tannewt/classic-2-trackball/hardware/electronics/PCBs/kicad/vertical_left/left-base.3mf

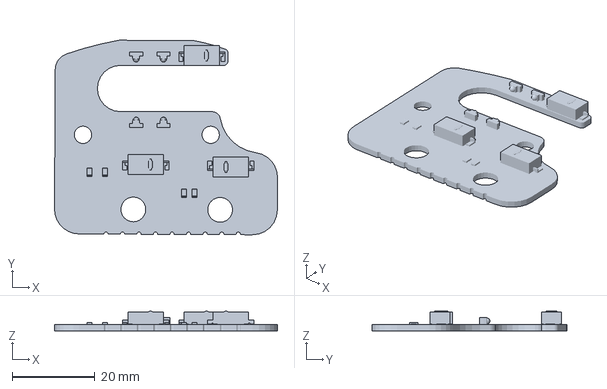
[picture p2: CAD file, 2026-08-16]
hardware/electronics/PCBs/kicad/vertical_left/left-base.3mf
53.9 x 47.1 x 4.80 mm
