tannewt/classic-2-trackball/hardware/electronics/PCBs/kicad/base2/left-base.step

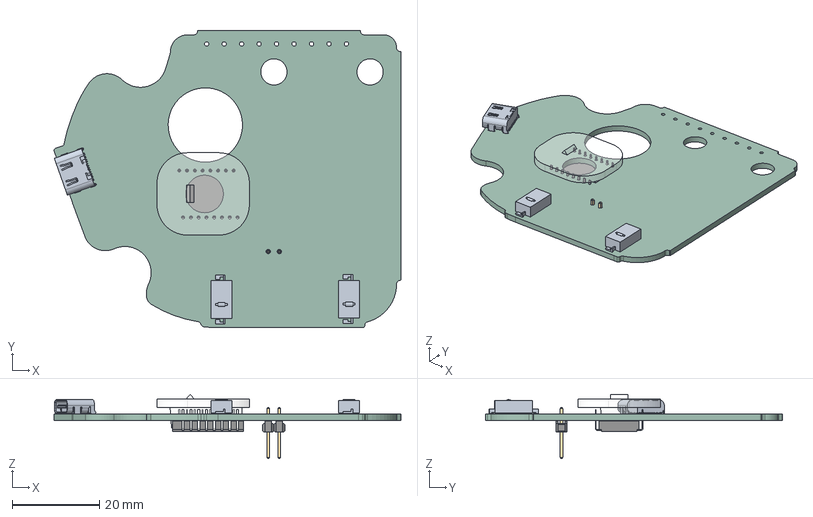
[picture p3: CAD file, 2026-03-19]
hardware/electronics/PCBs/kicad/base2/left-base.step
79.4 x 68.0 x 14.7 mm
K3D-DX07S016JA1-V1_JAE_Proprietary
D2LS_21_BUTTON x 2
D2LS_21_BASE x 2
M20-999-MOULD
M20-999-PIN x 2
LM19-LSI
PMW3360DM-T2QU
Base_PCB
