tannewt/classic-2-trackball/(list of files, cad)

Other CAD files:
hardware/electronics/PCBs/kicad/vertical_left/left-base.stl
