tannewt/classic-2-trackball/hardware/electronics/PCBs/kicad/base2/Base.kicad_pcb

## KiCad design hardware/electronics/PCBs/kicad/base2/Base.kicad_pcb (2026-08-25)

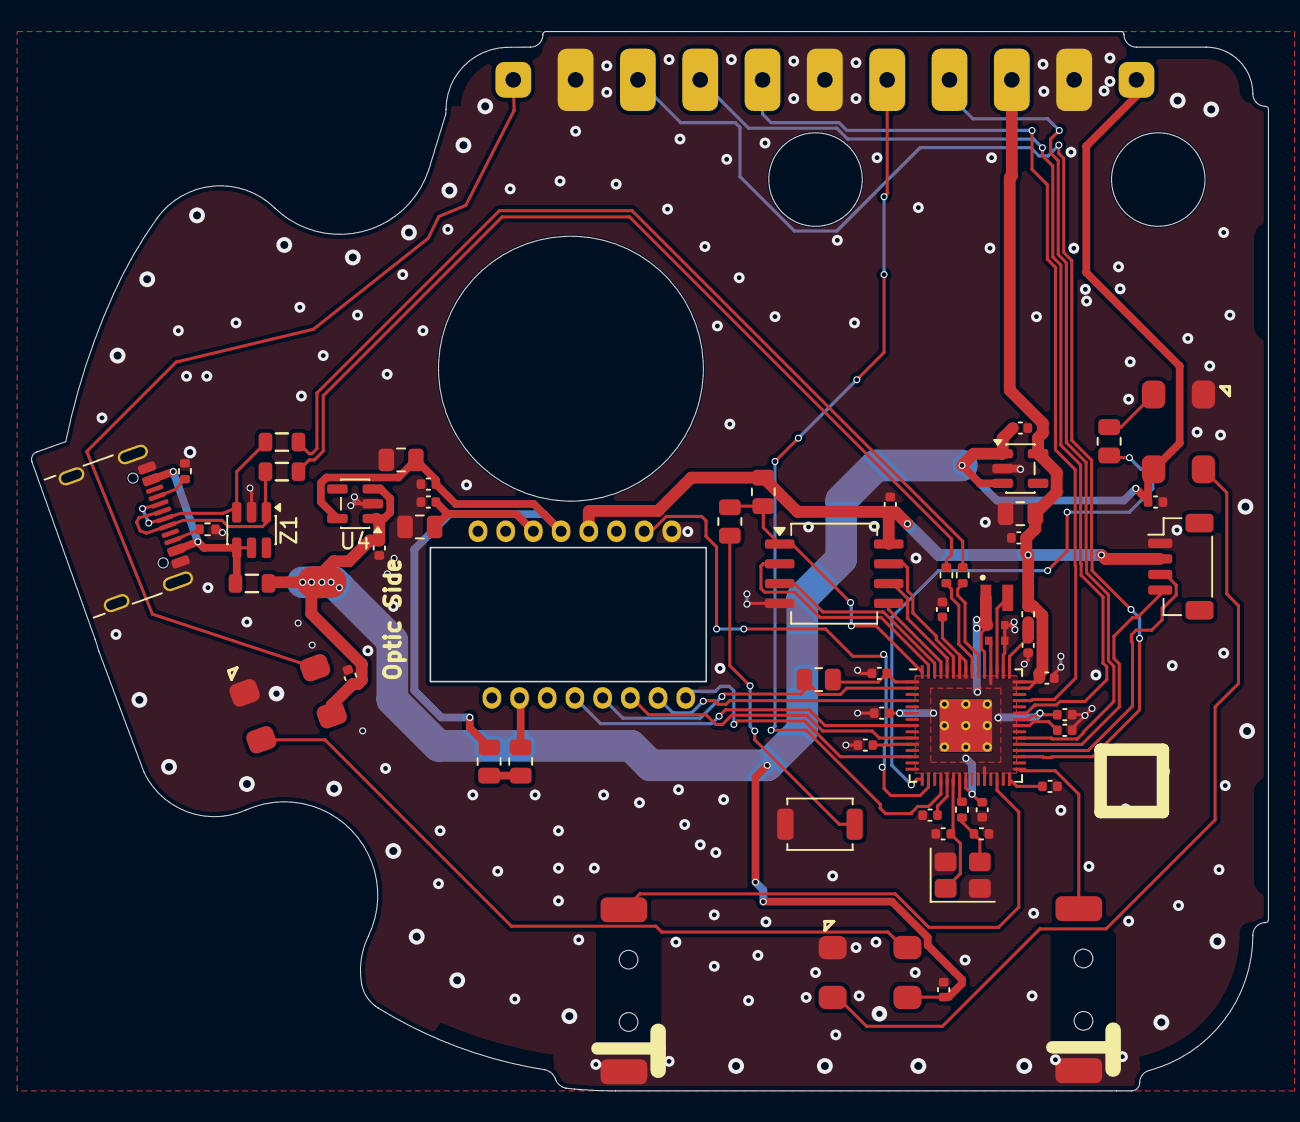
[picture p4: board hardware/electronics/PCBs/kicad/base2/Base.kicad_pcb from above]

Board: 2 copper layers, 79.4 x 68.0 mm, 69 parts (1 on the bottom side), 49 nets.

Parts:
C1, C11, C15, C20, C23, C24, C25, C29, C30, C31, C32, C33, C34, C35: 100nF; C_0402_1005Metric
C3, C4: 15pF; C_0402_1005Metric
C10, C13, C17: 10uF; C_0805_2012Metric
C12, C14, C16, C18: 1uF; C_0402_1005Metric
C22, C28: 4.7uF; C_0402_1005Metric
C26, C27: 4.7uF; C_0402_1005Metric_small_pads
CJ1, CJ2, CJ3, CJ4, CJ5, CJ6, CJ7, CJ8, CJ9, CJ10, CJ11: PCBJointCastellationJoint; PCBJoint
D1, D3, D5: IN-PI55TATPRPGPB
FB1, FB2, FB3: GZ2012D601TF; FB_0805
J3: USB_C_Receptacle_USB2.0_16P; USB_C_Receptacle_HRO_TYPE-C-31-M-31
J14: Conn_01x04; JST_SH_BM04B-SRSS-TB_1x04-1MP_P1.00mm_Vertical
L1: AOTA-B201610S3R3-101-T; L_pol_2016
R1, R16: 1k; R_0805_2012Metric
R2, R5: 10k; R_0805_2012Metric
R3, R4: 22R; R_0805_2012Metric
R6: 33; R_0402_1005Metric
R7, R8: 27; R_0402_1005Metric
R9: 1k; R_0402_1005Metric
R10, R11: 5.1k; R_0402_1005Metric
SW1, SW2: D2LS-21
SW3: TS-1088-AR02016; SW_SPST_TS-1088-xR020
U1: W25Q16JVSSIQ; SOIC-8_5.3x6.2mm_P1.27mm
U2: PMW3360DM-T2QU
U3: AP2202K-3.3; SOT-23-5
U4: AP2204K-1.8; SOT-23-5
U6: RP2350A; RP2350-QFN-60-1EP_7x7_P0.4mm_EP3.4x3.4mm_ThermalVias
Y1: ABM8-272-T3; Crystal_SMD_3225-4Pin_3.2x2.5mm
Z1: IP4220CZ6,125; SOT-23-6

Connections:
+1V1: C15.1, C22.1, C24.1, C27.1, L1.1, U6.6 (DVDD), U6.23 (DVDD), U6.39 (DVDD), U6.50 (VREG_FB)
+3.3V: C1.2, C13.2, C14.2, C26.1, C29.1, C30.1, C31.1, C32.1, C33.1, C34.1, C35.1, CJ8.1 (1_1), J14.2, R2.1, R5.2, R6.1, U1.8 (VCC), U2.5 (VDDIO), U3.5 (VOUT), U6.1 (IOVDD), U6.11 (IOVDD), U6.20 (IOVDD), U6.26 (RUN), U6.30 (IOVDD), U6.38 (IOVDD), U6.44 (ADC_AVDD), U6.45 (IOVDD), U6.49 (VREG_VIN), U6.53 (USB_OTP_VDD), U6.54 (QSPI_IOVDD)
/LBS/ButtonLittleFinger: SW2.B, U6.31 (GPIO19)
/LBS/ButtonRingFinger: SW1.B, U6.28 (GPIO17)
/LED/LEDData: R16.2, U6.16 (GPIO12)
/LED/LEDDataOut: CJ10.1 (1_1), D5.2 (DOUT)
/LED/V_USB: C12.2, C16.2, C20.2, C23.2, C25.2, CJ11.1 (1_1), D1.1 (VDD), D3.1 (VDD), D5.1 (VDD), FB1.2, U3.1 (VIN), U3.3 (EN), U4.1 (VIN), U4.3 (EN)
/MCU/ButtonLeftClick: CJ6.1 (1_1), U6.19 (GPIO15)
/MCU/ButtonRightClick: CJ7.1 (1_1), U6.36 (GPIO24)
/MCU/ButtonScrollWheel: CJ2.1 (1_1), U6.33 (GPIO21)
/MCU/CS: R1.2, R2.2, U1.1 (~CS), U6.60 (~QSPI_SS)
/MCU/D+: R8.2, U6.52 (USB_DP)
/MCU/D-: R7.2, U6.51 (USB_DM)
/MCU/MISO: R5.1, U2.12 (MISO), U6.2 (GPIO0)
/MCU/MOSI: U2.11 (MOSI), U6.10 (GPIO7)
/MCU/MOTION: U2.9 (MOTION), U6.13 (GPIO9)
/MCU/SCLK: U2.10 (SCLK), U6.4 (GPIO2)
/MCU/ScrollWheelOpto0: CJ3.1 (1_1), U6.40 (GPIO26/ADC0)
/MCU/ScrollWheelOpto1: CJ4.1 (1_1), U6.42 (GPIO28/ADC2)
/MCU/VREG_AVDD: C28.1, R6.2, U6.46 (VREG_AVDD)
/MCU/VREG_LX: L1.2, U6.48 (VREG_LX)
/MCU/XIN: C3.1, U6.21 (XIN), Y1.1
/MCU/XOUT: R9.1, U6.22 (XOUT)
/MCU/~CS: U2.13 (~CS), U6.8 (GPIO5)
/MCU/~RESET: U2.7 (~RESET), U6.17 (GPIO13)
/MOS/1V8: C17.2, C18.2, R3.2, U2.4 (VDD), U4.5 (VOUT)
/SCL: J14.4, U6.35 (GPIO23)
/SDA: J14.3, U6.34 (GPIO22)
/USB/USB_D+: FB3.2, R8.1
/USB/USB_D-: FB2.2, R7.1
GND: C1.1, C3.2, C4.2, C10.1, C11.1, C12.1, C13.1, C14.1, C15.2, C16.1, C17.1, C18.1, C20.1, C22.2, C23.1, C24.2, C25.1, C26.2, C27.2, C28.2, C29.2, C30.2, C31.2, C32.2, C33.2, C34.2, C35.2, CJ1.1 (1_1), CJ5.1 (1_1), CJ9.1 (1_1), D1.3 (VSS), D3.3 (VSS), D5.3 (VSS), J3.A1 (GND), J3.A12 (GND), J3.B1 (GND), J3.B12 (GND), J3.SH (SHIELD), J14.1, R10.2, R11.2, SW1.A, SW2.A, SW3.1, U1.4 (GND), U2.8 (GND), U3.2 (GND), U4.2 (GND), U6.47 (VREG_PGND), U6.61 (GND), Y1.2, Y1.4, Z1.2
unnamed: C4.1, R9.2, Y1.3
unnamed: D1.4 (DIN), R16.1
unnamed: D1.2 (DOUT), D3.4 (DIN)
unnamed: D3.2 (DOUT), D5.4 (DIN)
unnamed: FB1.1, J3.A4 (VBUS), J3.A9 (VBUS), J3.B4 (VBUS), J3.B9 (VBUS), Z1.4, Z1.5
unnamed: FB2.1, J3.A7 (D-), J3.B7 (D-), Z1.3
unnamed: FB3.1, J3.A6 (D+), J3.B6 (D+), Z1.1
unnamed: J3.A5 (CC1), R10.1
unnamed: J3.B5 (CC2), R11.1
unnamed: R1.1, SW3.2
unnamed: R3.1, R4.2
unnamed: U1.6 (CLK), U6.56 (QSPI_SCLK)
unnamed: U1.5 (DI_(IO0)), U6.57 (QSPI_SD0)
unnamed: U1.2 (DO_(IO1)), U6.59 (QSPI_SD1)
unnamed: U1.7 (~HOLD_or_~RESET_(IO3)), U6.55 (QSPI_SD3)
unnamed: U1.3 (~WP_(IO2)), U6.58 (QSPI_SD2)
unnamed: R4.1, U2.15 (LED_P)
unnamed: C10.2, C11.2, U2.3 (VDDPIX)
