tannewt/classic-2-trackball/hardware/electronics/PCBs/kicad/vertical_left/Vertical.kicad_pcb

## KiCad design hardware/electronics/PCBs/kicad/vertical_left/Vertical.kicad_pcb (2026-08-16)

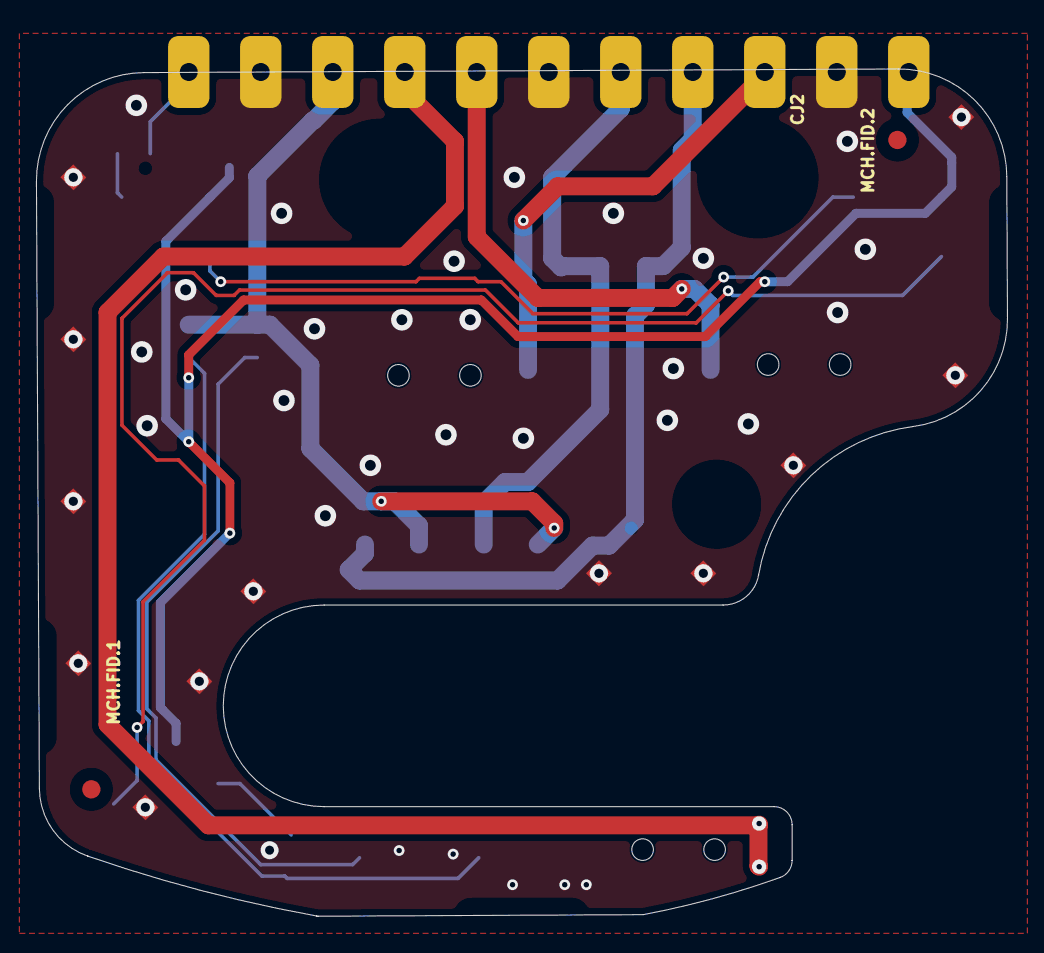
[picture p5: board Vertical.kicad_pcb from above]

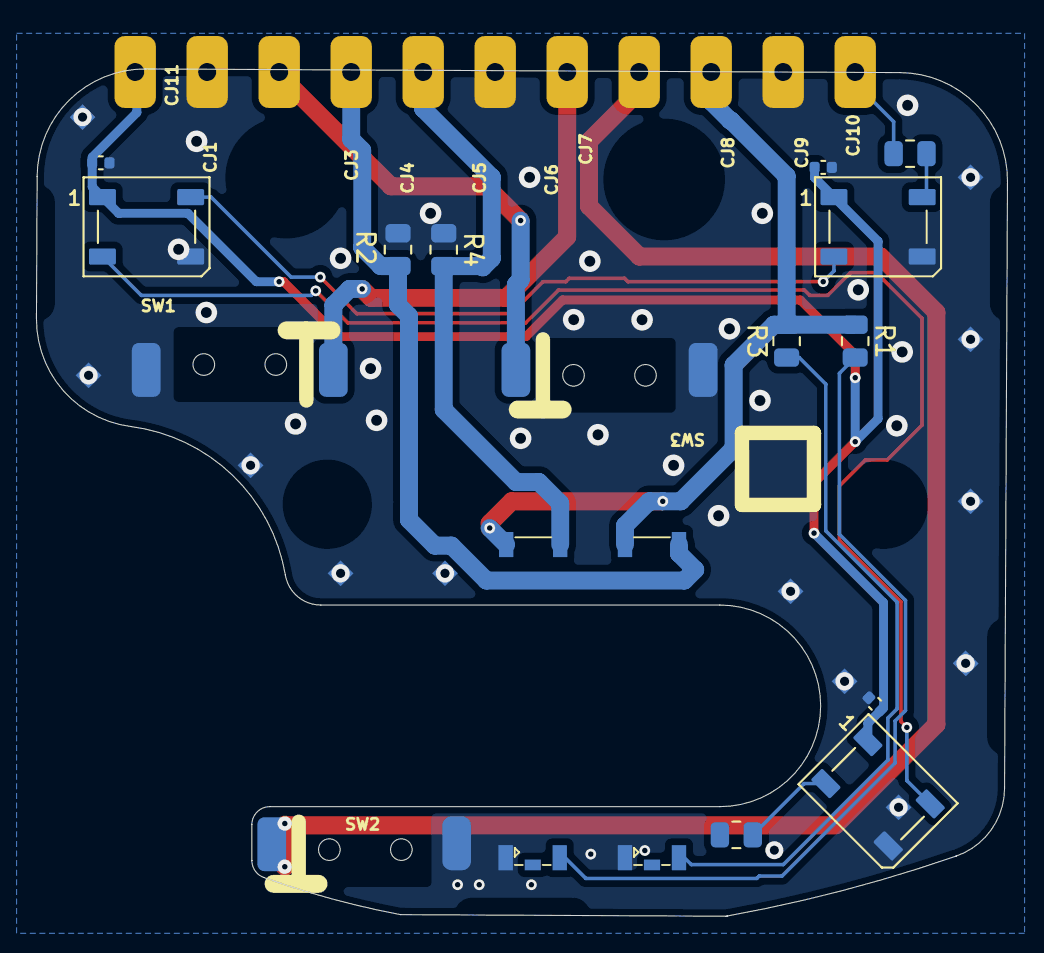
[picture p6: board Vertical.kicad_pcb from below]

Board: 2 copper layers, 53.9 x 47.1 mm, 46 parts (19 on the bottom side), 15 nets.

Parts:
C20, C23, C25: 100nF; C_0402_1005Metric
CJ1, CJ2, CJ3, CJ4, CJ5, CJ6, CJ7, CJ8, CJ9, CJ10, CJ11: PCBJointCastellationJoint; PCBJoint
D1, D2: IR12-21C/TR8 or VSMB10940; IR12-21CTR8
D3, D4, D5: IN-PI55TATPRPGPB; LED_WS2812B_PLCC4_5.0x5.0mm_P3.2mm
MCH.FID.1, MCH.FID.2: IPC-7351 Fiducial 1mm; FIDUCIAL_1.5
MCH.FID.3, MCH.FID.4: 1mm Fiducial for OpenPNP; FIDUCIAL-NEW
MCH.SP.1, MCH.SP.2, MCH.SP.3, MCH.SP.4, MCH.SP.5, MCH.SP.6, MCH.SP.7, MCH.SP.8, MCH.SP.9, MCH.SP.10, MCH.SP.11, MCH.SP.12: Spark Gap; SparkGap
Q1, Q2: PT26-51B/TR8; PT26-51B-TR8
R1, R3: 100; R_0805_2012Metric
R2, R4, R16, R17: 1k; R_0805_2012Metric
SW1, SW2, SW3: D2LS-21

Connections:
/BBS/ButtonLeftClick: CJ6.1 (1_1), SW1.A
/BBS/ButtonRightClick: CJ7.1 (1_1), SW2.A
/LEDs/LEDData: CJ10.1 (1_1), R16.2
/LEDs/V_USB: C20.2, C23.2, C25.2, CJ11.1 (1_1), D3.1 (VDD), D4.1 (VDD), D5.1 (VDD)
/SCW/3V3: CJ8.1 (1_1), Q1.2 (C), Q2.2 (C), R1.1, R3.2
/SCW/ButtonScrollWheel: CJ2.1 (1_1), SW3.A
/SCW/ScrollWheelOpto0: CJ3.1 (1_1), Q1.1 (E), R2.2
/SCW/ScrollWheelOpto1: CJ4.1 (1_1), Q2.1 (E), R4.2
GND: C20.1, C23.1, C25.1, CJ1.1 (1_1), CJ5.1 (1_1), CJ9.1 (1_1), D1.2 (C), D2.2 (C), D3.3 (VSS), D4.3 (VSS), D5.3 (VSS), MCH.SP.1.1, MCH.SP.2.1, MCH.SP.3.1, MCH.SP.4.1, MCH.SP.5.1, MCH.SP.6.1, MCH.SP.7.1, MCH.SP.8.1, MCH.SP.9.1, MCH.SP.10.1, MCH.SP.11.1, MCH.SP.12.1, R2.1, R4.1, SW1.B, SW2.B, SW3.B
unnamed: D1.1 (A), R1.2
unnamed: D2.1 (A), R3.1
unnamed: D3.4 (DIN), R16.1
unnamed: D3.2 (DOUT), D4.4 (DIN)
unnamed: D4.2 (DOUT), D5.4 (DIN)
unnamed: D5.2 (DOUT), R17.1 (1_1)
