tannewt/classic-2-trackball/hardware/electronics/PCBs/kicad/right_base/Base.kicad_pcb

## KiCad design hardware/electronics/PCBs/kicad/right_base/Base.kicad_pcb (2026-03-19)

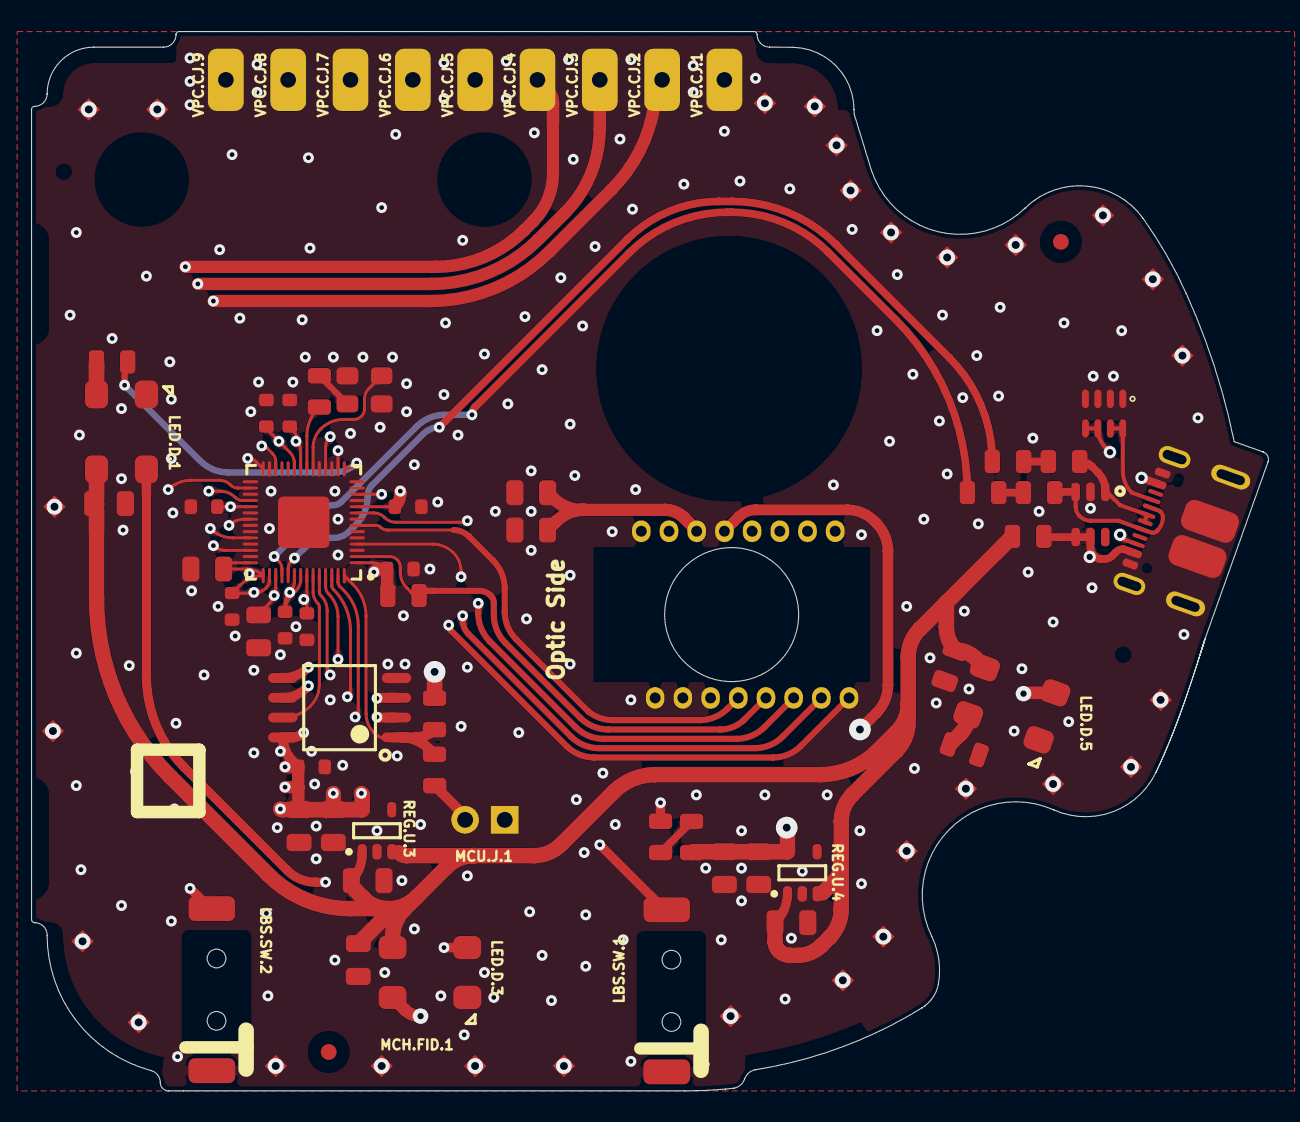
[picture p7: board hardware/electronics/PCBs/kicad/right_base/Base.kicad_pcb from above]

Board: 4 copper layers, 79.4 x 68.0 mm, 91 parts (1 on the bottom side), 45 nets.

Parts:
LBS.SW.1, LBS.SW.2: D2LS-21
LED.C.20, LED.C.23, LED.C.25: 0805; 0805 - TALL
LED.D.1, LED.D.3, LED.D.5: IN-PI55TATPRPGPB
LED.R.16, LED.R.18: 0805
MCH.FID.1, MCH.FID.2: IPC-7351 Fiducial 1mm; FIDUCIAL_1.5
MCH.FID.3, MCH.FID.4: 1mm Fiducial for OpenPNP; FIDUCIAL-NEW
MCH.SP.1, MCH.SP.2, MCH.SP.3, MCH.SP.4, MCH.SP.5, MCH.SP.6, MCH.SP.7, MCH.SP.8, MCH.SP.9, MCH.SP.10, MCH.SP.11, MCH.SP.12, MCH.SP.13, MCH.SP.14, MCH.SP.15, MCH.SP.16, MCH.SP.17, MCH.SP.18, MCH.SP.19, MCH.SP.20, MCH.SP.21, MCH.SP.22, MCH.SP.23, MCH.SP.24, MCH.SP.25, MCH.SP.26, MCH.SP.27, MCH.SP.28: Spark Gap; SparkGap
MCU.C.1, MCU.C.3, MCU.C.4, MCU.C.5, MCU.C.6, MCU.C.7, MCU.C.8, MCU.C.19, MCU.C.21: 0603 X5R; 0603 capacitor - CAPC1608X06N
MCU.C.2, MCU.C.9: 0805 X5R; 0805 - TALL
MCU.J.1: HEADER2; 2x1
MCU.R.1, MCU.R.2, MCU.R.6: 0805
MCU.U.1: W25Q16JVSSIQ; W25Q128JVS - SOIC127P790X216-8M
MCU.U.5: RP2040; RP2040 - QFN40P700X700X90_HS-57M
MCU.Y.1: RH100-12.000-16-3030
MOS.C.10, MOS.C.11: 0805; 0805 - TALL
MOS.R.3, MOS.R.4, MOS.R.5: 0805
MOS.U.2: PMW3360DM-T2QU
REG.C.12, REG.C.13, REG.C.14, REG.C.16, REG.C.17, REG.C.18: 0805; 0805 - TALL
REG.U.3: AP2202K-3.3; AP2202 - SOT95P270X145-5N
REG.U.4: AP2204K-1.8; AP2202 - SOT95P270X145-5N
USB.FB.1, USB.FB.2, USB.FB.3: ACML-0805-601-T; 0805
USB.J.2: DX07S016JA1R1500
USB.R.7, USB.R.8: 0805
USB.Ra.1: 1206 Quad; 4x 10k 1% - CAC-80P320X160-8M
USB.Z.1: IP4220CZ6,125; PESD3V3S4UD - SOT95P275X110-6N
VPC.CJ.1, VPC.CJ.2, VPC.CJ.3, VPC.CJ.4, VPC.CJ.5, VPC.CJ.6, VPC.CJ.7, VPC.CJ.8, VPC.CJ.9: PCBJointCastellationJoint; PCBJoint

Connections:
1V1: MCU.C.9.2, MCU.C.19.2, MCU.C.21.2, MCU.U.5.23, MCU.U.5.45, MCU.U.5.50
1V8: MOS.R.3.2, MOS.U.2.4, REG.C.17.2, REG.C.18.2, REG.U.4.5
3V3: MCU.C.1.2, MCU.C.2.2, MCU.C.3.2, MCU.C.4.2, MCU.C.5.2, MCU.C.6.2, MCU.C.7.2, MCU.C.8.2, MCU.R.2.1, MCU.U.1.8, MCU.U.5.1, MCU.U.5.10, MCU.U.5.22, MCU.U.5.26, MCU.U.5.33, MCU.U.5.42, MCU.U.5.43, MCU.U.5.44, MCU.U.5.48, MCU.U.5.49, MOS.R.5.2, MOS.U.2.5, REG.C.13.2, REG.C.14.2, REG.U.3.5, VPC.CJ.8.1
GND: LBS.SW.1.A, LBS.SW.2.A, LED.C.20.1, LED.C.23.1, LED.C.25.1, LED.D.1.3, LED.D.3.3, LED.D.5.3, MCH.SP.1.1, MCH.SP.2.1, MCH.SP.3.1, MCH.SP.4.1, MCH.SP.5.1, MCH.SP.6.1, MCH.SP.7.1, MCH.SP.8.1, MCH.SP.9.1, MCH.SP.10.1, MCH.SP.11.1, MCH.SP.12.1, MCH.SP.13.1, MCH.SP.14.1, MCH.SP.15.1, MCH.SP.16.1, MCH.SP.17.1, MCH.SP.18.1, MCH.SP.19.1, MCH.SP.20.1, MCH.SP.21.1, MCH.SP.22.1, MCH.SP.23.1, MCH.SP.24.1, MCH.SP.25.1, MCH.SP.26.1, MCH.SP.27.1, MCH.SP.28.1, MCU.C.1.1, MCU.C.2.1, MCU.C.3.1, MCU.C.4.1, MCU.C.5.1, MCU.C.6.1, MCU.C.7.1, MCU.C.8.1, MCU.C.9.1, MCU.C.19.1, MCU.C.21.1, MCU.J.1.1, MCU.U.1.4, MCU.U.5.3, MCU.U.5.5, MCU.U.5.6, MCU.U.5.8, MCU.U.5.11, MCU.U.5.13, MCU.U.5.14, MCU.U.5.17, MCU.U.5.19, MCU.U.5.27, MCU.U.5.29, MCU.U.5.31, MCU.U.5.34, MCU.U.5.36, MCU.U.5.37, MCU.U.5.39, MCU.U.5.41, MCU.U.5.57, MCU.Y.1.2, MCU.Y.1.4, MOS.C.10.1, MOS.C.11.1, MOS.U.2.8, REG.C.12.1, REG.C.13.1, REG.C.14.1, REG.C.16.1, REG.C.17.1, REG.C.18.1, REG.U.3.2, REG.U.4.2, USB.J.2.1, USB.J.2.12, USB.J.2.SHELL, USB.Ra.1.1, USB.Ra.1.2, USB.Ra.1.3, USB.Ra.1.4, USB.Z.1.2, VPC.CJ.1.1, VPC.CJ.5.1, VPC.CJ.9.1
LEDData: LED.R.16.2, MCU.U.5.15
NetLBS.SW.1_B: LBS.SW.1.B, MCU.U.5.28
NetLBS.SW.2_B: LBS.SW.2.B, MCU.U.5.30
NetLED.D.1_2: LED.D.1.2, LED.D.3.4
NetLED.D.1_4: LED.D.1.4, LED.R.16.1
NetLED.D.3_2: LED.D.3.2, LED.D.5.4
NetLED.D.5_2: LED.D.5.2, LED.R.18.2
NetMCU.J.1_2: MCU.J.1.2, MCU.R.1.1
NetMCU.R.1_2: MCU.R.1.2, MCU.R.2.2, MCU.U.1.1, MCU.U.5.56
NetMCU.R.6_1: MCU.R.6.1, MCU.U.5.21
NetMCU.R.6_2: MCU.R.6.2, MCU.Y.1.3
NetMCU.U.1_2: MCU.U.1.2, MCU.U.5.55
NetMCU.U.1_3: MCU.U.1.3, MCU.U.5.54
NetMCU.U.1_5: MCU.U.1.5, MCU.U.5.53
NetMCU.U.1_6: MCU.U.1.6, MCU.U.5.52
NetMCU.U.1_7: MCU.U.1.7, MCU.U.5.51
NetMCU.U.5_2: MCU.U.5.2, MOS.R.5.1, MOS.U.2.12
NetMCU.U.5_4: MCU.U.5.4, MOS.U.2.10
NetMCU.U.5_7: MCU.U.5.7, MOS.U.2.13
NetMCU.U.5_9: MCU.U.5.9, MOS.U.2.11
NetMCU.U.5_12: MCU.U.5.12, MOS.U.2.9
NetMCU.U.5_16: MCU.U.5.16, MOS.U.2.7
NetMCU.U.5_18: MCU.U.5.18, VPC.CJ.6.1
NetMCU.U.5_20: MCU.U.5.20, MCU.Y.1.1
NetMCU.U.5_32: MCU.U.5.32, VPC.CJ.2.1
NetMCU.U.5_35: MCU.U.5.35, VPC.CJ.7.1
NetMCU.U.5_38: MCU.U.5.38, VPC.CJ.3.1
NetMCU.U.5_40: MCU.U.5.40, VPC.CJ.4.1
NetMCU.U.5_46: MCU.U.5.46, USB.R.7.2
NetMCU.U.5_47: MCU.U.5.47, USB.R.8.2
NetMOS.C.10_2: MOS.C.10.2, MOS.C.11.2, MOS.U.2.3
NetMOS.R.3_1: MOS.R.3.1, MOS.R.4.2
NetMOS.R.4_1: MOS.R.4.1, MOS.U.2.15
NetUSB.FB.1_1: USB.FB.1.1, USB.J.2.2, USB.J.2.11, USB.Z.1.4, USB.Z.1.5
NetUSB.FB.2_1: USB.FB.2.1, USB.J.2.5, USB.J.2.8, USB.Z.1.3
NetUSB.FB.2_2: USB.FB.2.2, USB.R.7.1
NetUSB.FB.3_1: USB.FB.3.1, USB.J.2.6, USB.J.2.7, USB.Z.1.1
NetUSB.FB.3_2: USB.FB.3.2, USB.R.8.1
NetUSB.J.2_3: USB.J.2.3, USB.Ra.1.5, USB.Ra.1.6
NetUSB.J.2_9: USB.J.2.9, USB.Ra.1.7, USB.Ra.1.8
V_USB: LED.C.20.2, LED.C.23.2, LED.C.25.2, LED.D.1.1, LED.D.3.1, LED.D.5.1, REG.C.12.2, REG.C.16.2, REG.U.3.1, REG.U.3.3, REG.U.4.1, REG.U.4.3, USB.FB.1.2
