tannewt/classic-2-trackball/(commit log)

2026-03-19 Working on left
    [Base.kicad_pcb, Base.kicad_sch, LEDs.kicad_sch, LittleButtons.kicad_sch, MCU.kicad_sch, Mechanical.kicad_sch, MouseSensor.kicad_sch, Regulators.kicad_sch]
2026-03-19 Kicad nightly import
    [Base.kicad_pcb, Base.kicad_sch, LEDs.kicad_sch, LittleButtons.kicad_sch, MCU.kicad_sch, Mechanical.kicad_sch, MouseSensor.kicad_sch, Regulators.kicad_sch]
2026-06-08 add vertical
    [.step, Base.kicad_pcb, BigButtons.kicad_sch, LEDs.kicad_sch, MCU.kicad_sch, Mechanical.kicad_sch, MouseSensor.kicad_sch, Regulators.kicad_sch]
2026-06-08 Vertical portion flipped
    [BOM-Vertical.csv, BigButtons.kicad_sch, Mechanical.kicad_sch, ScrollWheel.kicad_sch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]
2026-06-09 Getting parts right
    [Base.kicad_pcb, LEDs.kicad_sch, MCU.kicad_sch, MouseSensor.kicad_sch, Regulators.kicad_sch, USB.kicad_sch]
2026-06-09 To order
    [Base-CuBottom.gbr, Base-CuTop.gbr, Base-EdgeCuts.gbr, Base-MaskBottom.gbr, Base-MaskTop.gbr, Base-NPTH.drl, Base-PTH.drl, Base-PasteBottom.gbr]
2026-07-27 Vertical neopixels
    [Base-CuBottom.gbr, Base-CuTop.gbr, Base-EdgeCuts.gbr, Base-MaskBottom.gbr, Base-MaskTop.gbr, Base-NPTH.drl, Base-PTH.drl, Base-PasteBottom.gbr]
2026-07-27 PCB revs. Add vertical rgb leds. Fix sensor cutout
    [BOM-Vertical.csv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]
2026-08-16 Correct IR footprints
    [BOM-Vertical.csv, ScrollWheel.kicad_sch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]
2026-08-25 Add the holes back. 🤦
    [Base.kicad_pcb]
