tannewt/classic-2-trackball/(notices)

Notices in the files:
hardware/electronics/PCBs/kicad/right_base/VerticalPCBConnection.kicad_sch:
Licensed under the CERN-OHL-S v2
Copyright Ploopy Corporation 2024
hardware/electronics/PCBs/kicad/right_base/Base.kicad_sch:
This source describes Open Hardware and is licensed under the CERN-OHL-S v2.
You may redistribute and modify this source and make products using it under the terms of the CERN-OHL-S v2 (https://ohwr.org/cernohlsv2.txt). This source is distributed WITHOUT ANY EXPRESS OR IMPLIED WARRANTY, INCLUDING OF MERCHANTABILITY, SATISFACTORY QUALITY AND FITNESS FOR A PARTICULAR PURPOSE.
As per CERN-OHL-S v2 section 4, should You produce hardware based on this source, You must where practicable maintain the Source Location visible on the external case of the Ploopy Classic Trackball or other products you make using this source.
hardware/electronics/PCBs/kicad/right_base/Base.kicad_pcb:
CERN-OHL-S v2
hardware/electronics/PCBs/kicad/vertical_left/Vertical.kicad_pcb:
Copyright Ploopy 2024
hardware/electronics/PCBs/kicad/base2/Base.kicad_pcb:
Copyright Scott Shawcroft
